teeheee/usring/README.md

# Us Sensor Ring (short usring) 

These are all files needed to manufacture, use, modify and programm the sensoring.
More information can be found in "doku/usring-doku.pdf".

# Credit

* twi library from Martin Junghans
* uart library from Peter Fleury
