teeheee/usring/layout/README

TODO:
	am multiplexer VEE->GND nicht VCC!!!
	sensor nummerierung überarbeiten
	10 poliger goldboard5 stecker
