teeheee/usring/doku/usring-doku.pdf

# Usring Dokumentation

Alexander Ulbrich

7. M¨arz 2018

1

## Inhaltsverzeichnis

1 Hardware | 2
2 Software | 3
3 Bestellliste | 7
4 Bestuckungsplan | 7 ¨

1

## 1 Hardware

### 1.1 Schaltplan


2

### 1.2 Bemaßung

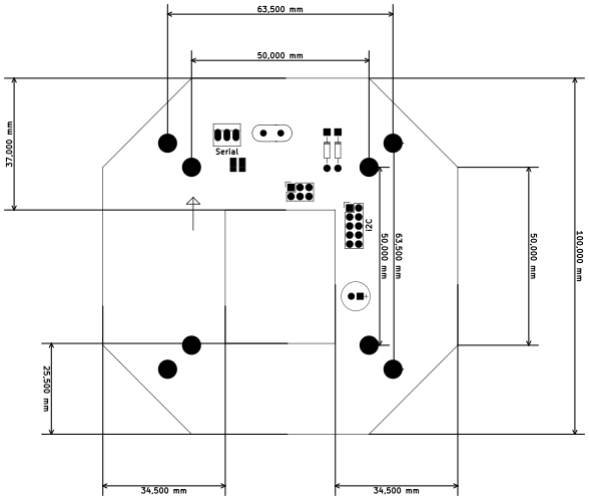
[picture p4: figure]

## 2 Software

### 2.1 usring Klasse

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

3

### 2.2 Verwendung der usring Klasse

### 2.2.1 Konstruktor

Initialisert die gesammte Hardware.

U s rin g ri n g ; // wie Goldboard gb;

### 2.2.2 Sensor getDifferenceValue

getDifferenceValue misst alle Sensoren einmal mit und einmal ohne LED Be-leuchtung. Die Differenz der Messung wird im int Array valueBuffer gespeichert. valueBuffer muss die Laenge 16 haben.

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

### 2.2.3 Sensor getAnalogValue

getAnalogValue gibt den Analogwert des Sensors mit der Nummer id zurueck. Achtung! Es wird keine Differenz gemessen.

ri n g . ge tAnalogValue ( u i n t 8 t i d ) ;

### 2.2.4 Sensor setLed

setLed schaltet die LED an, wenn state ¿ 0 und aus wenn state = 0 ist.

ri n g . se tLed ( u i n t 8 t s t a t e ) ;

### 2.2.5 I2C setI2C

setI2C setzt den Wert value in das register mit der Nummer id. Der Wert einer bestimmten id kann direkt ueber i2c vom Master ausgelesen werden.

ri n g . s e t I 2C ( u i n t 8 t id , u i n t 8 t v al u e ) ;

### 2.2.6 I2C setI2CData

setI2CData setzt den Wert der Register mit der Nummer id bis zur Nummer id+size auf Werte in dem Array data mit der l¨ange size.

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

Beispiel:

int x = 1 0;
ri n g . set I2CData ( 0 , 2 , ( u i n t 8 t ∗)&x ) ;

4

### 2.2.7 I2C getI2C

getI2C gibt den Wert des Eingangs Registers mit der Nummer id zurueck. der I2C Master hat die Moeglichkeit diese Register zu setzen.

ri n g . ge t I2C ( u i n t 8 t i d ) ;

### 2.2.8 UART print

gibt die Zeichenkette string ueber Uart aus.

ri n g . p r i n t ( const char∗ s t r i n g ) ;

gibt den Wert des Integeres value als ASCII ueber Uart aus.

ri n g . p r i n t ( int v al u e ) ;

### 2.3 Beispielcode

#i n cl u d e ” u s ri n g . h”

U s rin g ri n g ;

int mi t t el w e r t [ 1 6 ] ; int we r te [ 1 6 ] ;
u i n t 1 6 t ausgabe ;

void k a l i b r i e r e n ( )
{
// mittelwerte auf 0 setzen for ( int x = 0 ; x < 1 6; x++)
mi t t el w e r t [ x ] = 0 ;

//10 Messwerte Aufnehmen und den mittelwert Berechnen for ( int x = 0 ; x < 1 0; x++)
{
ri n g . g e t Di f f e r e n c e V al u e ( we r te ) ;
for ( int i = 0 ; i < 1 6; i++) mi t t el w e r t [ i ] += we r te [ i ] ; d el a y ( 1 0 ) ;
}
for ( int x = 0 ; x < 1 6; x++) mi t t el w e r t [ x ] /= 1 0;
}

void messen ( )
{
ri n g . g e t Di f f e r e n c e V al u e ( we r te ) ; }

5

void be rechnen ( )
{
// Schwellwerte auswerten und
// | Ergebnisse in 16 bit Typ Speichern
ausgabe = 0 ;
for ( int x = 0 ; x < 1 6; x++)
{
| // offset auf den mittelwert addieren if ( we r te [ x ] > mi t t el w e r t [ x ] + 1 0 )

{
| // setze das bit auf 1 wenn der sensor was sieht ausgabe |= (1<<x ) ;

}
}
}

// daten in i2c Puffer Schreiben void ausgeben ( )
{
//16 bit Variable schreiben
ri n g . set I2CData ( 0 , 2 , ( u i n t 8 t ∗)& ausgabe ) ; for ( int x = 0 ; x < 1 6; x++)
// analog werte schreiben
ri n g . s e t I 2C ( x+2, we r te [ x ] ) ;
}

int main ( void ) {
k a l i b r i e r e n ( ) ; while ( 1 ) {
messen ( ) ;
be rechnen ( ) ;
ausgeben ( ) ;
}
}

6

## 3 Bestellliste

Package | Anzahl | Wert
R 0805 | 16 | 470R
R 0805 | 3 | 1k
R 0805 | 17 | 10k
R 0805 | 2 | 4,7k
C 0805 | 4 | 100n
C 0805 | 2 | 22p
CP Radial D8.0mm P2.50mm | 1 | 100u
SFH3710 | 16 | SFH3710
1206 LED | 16 | LED
Diode throughole | 2 | D
SMD-shotkey | 1 | ZENER 5,1V
SOT23 | 1 | Q NMOS DGS
QUARZ-HC49 | 1 | QUARZ
Wannenstecker 2x05 | 1 | I2C
Shotkey-SOD-123 | 4 | D Schottky
atmega8-TQFP | 1 | ATMEGA88-A
74HC4051-SO16 | 2 | 74HC4051

## 4 Bestuckungsplan ¨

Bei der Bestuckung ist zu beachten, dass der Pin VEE mit GND verbunden ¨ werden muss (neben dran) die Verbindung mit VCC muss gekappt werden! Die Jumper 1 und 2 mussen wie folgt konfiguriert werden ¨


### 4.1 Oberseite

7

# 1x 10 - 100 uF, CP_Radial_Tantal_D8.0mm_P2.50mm

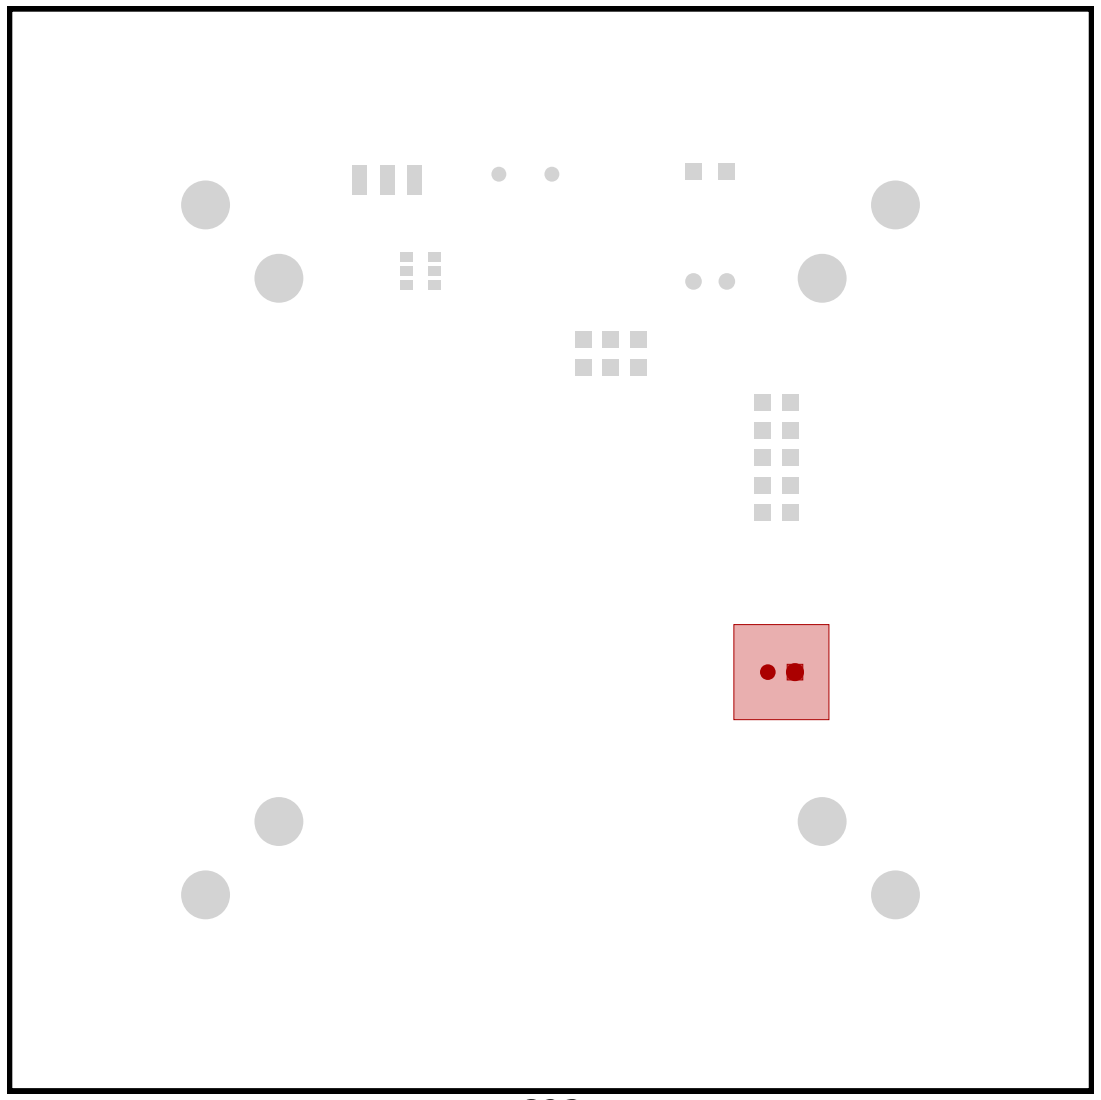
[picture p5: figure]

C23

# 2x D, Diode_throughole

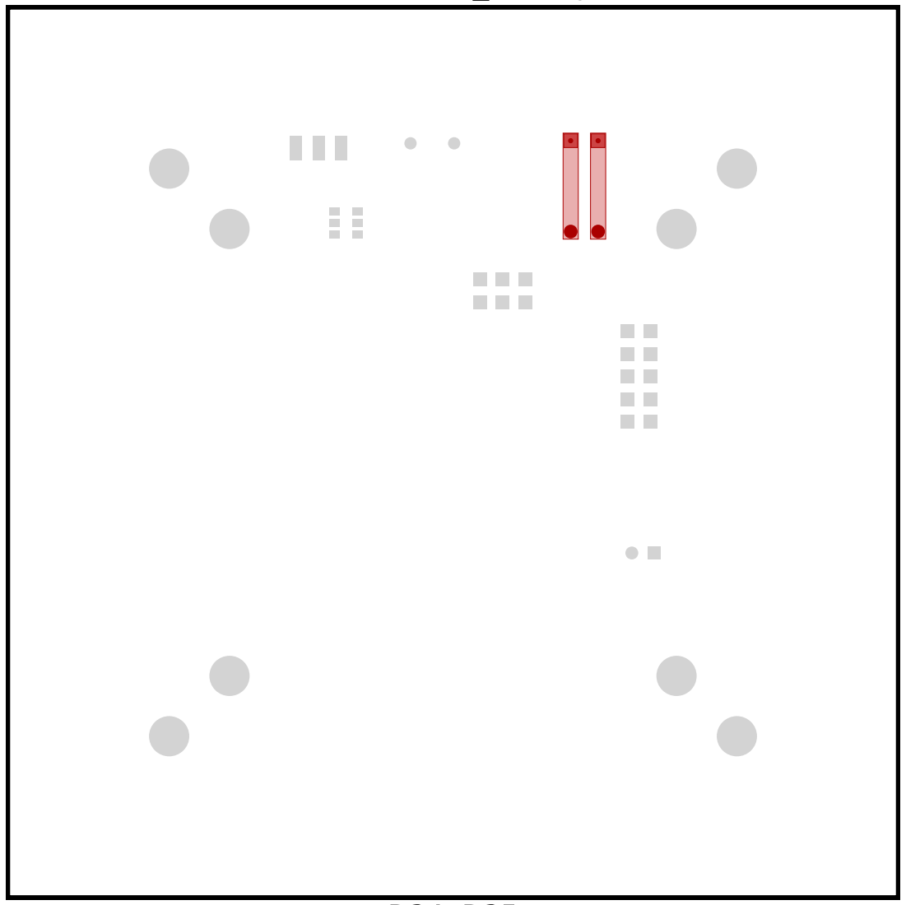
[picture p6: figure]

D34, D35

# 1x 16Mhz, QUARZ-HC49

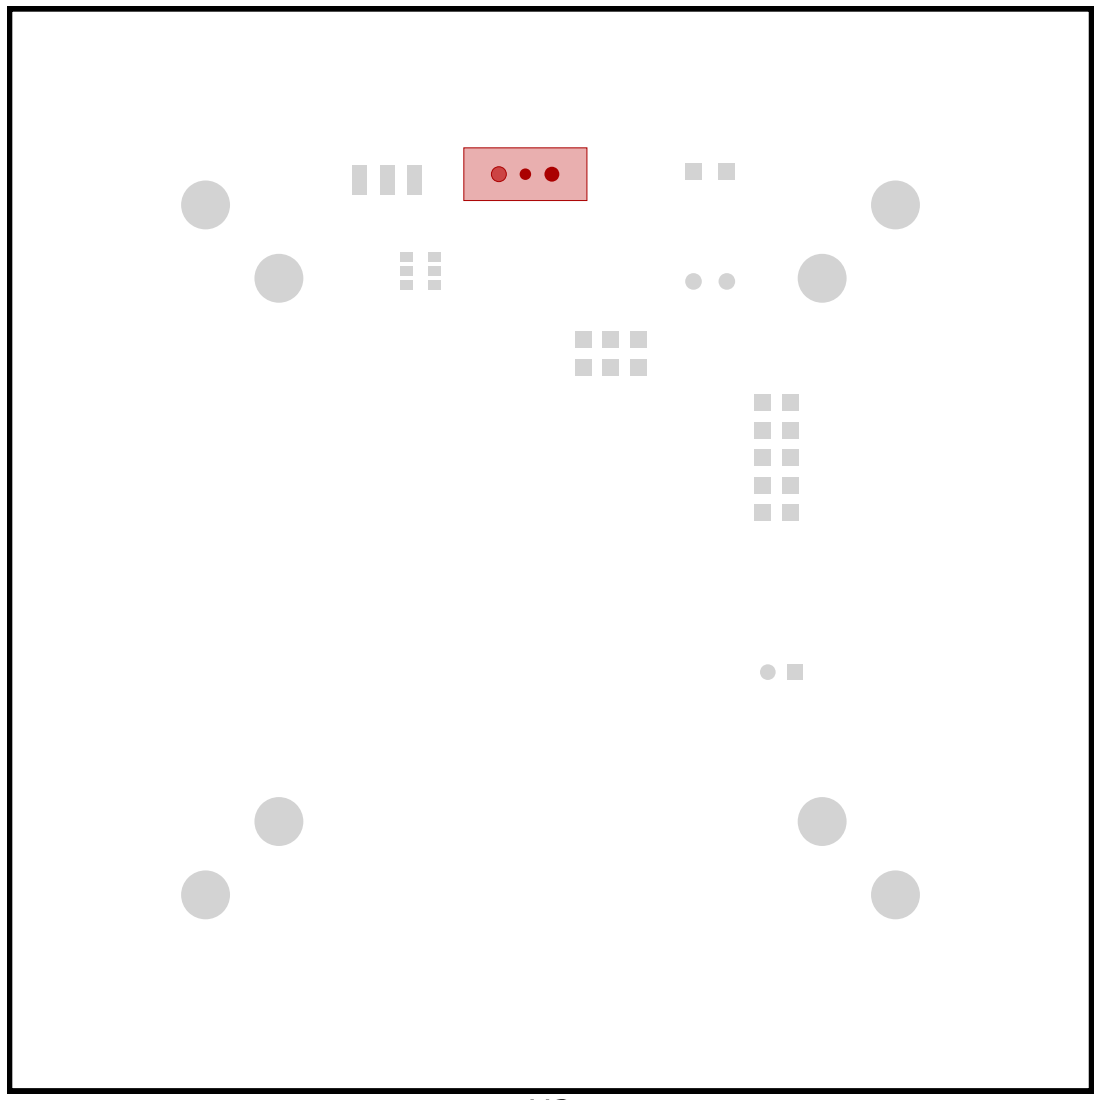
[picture p7: figure]

U3

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

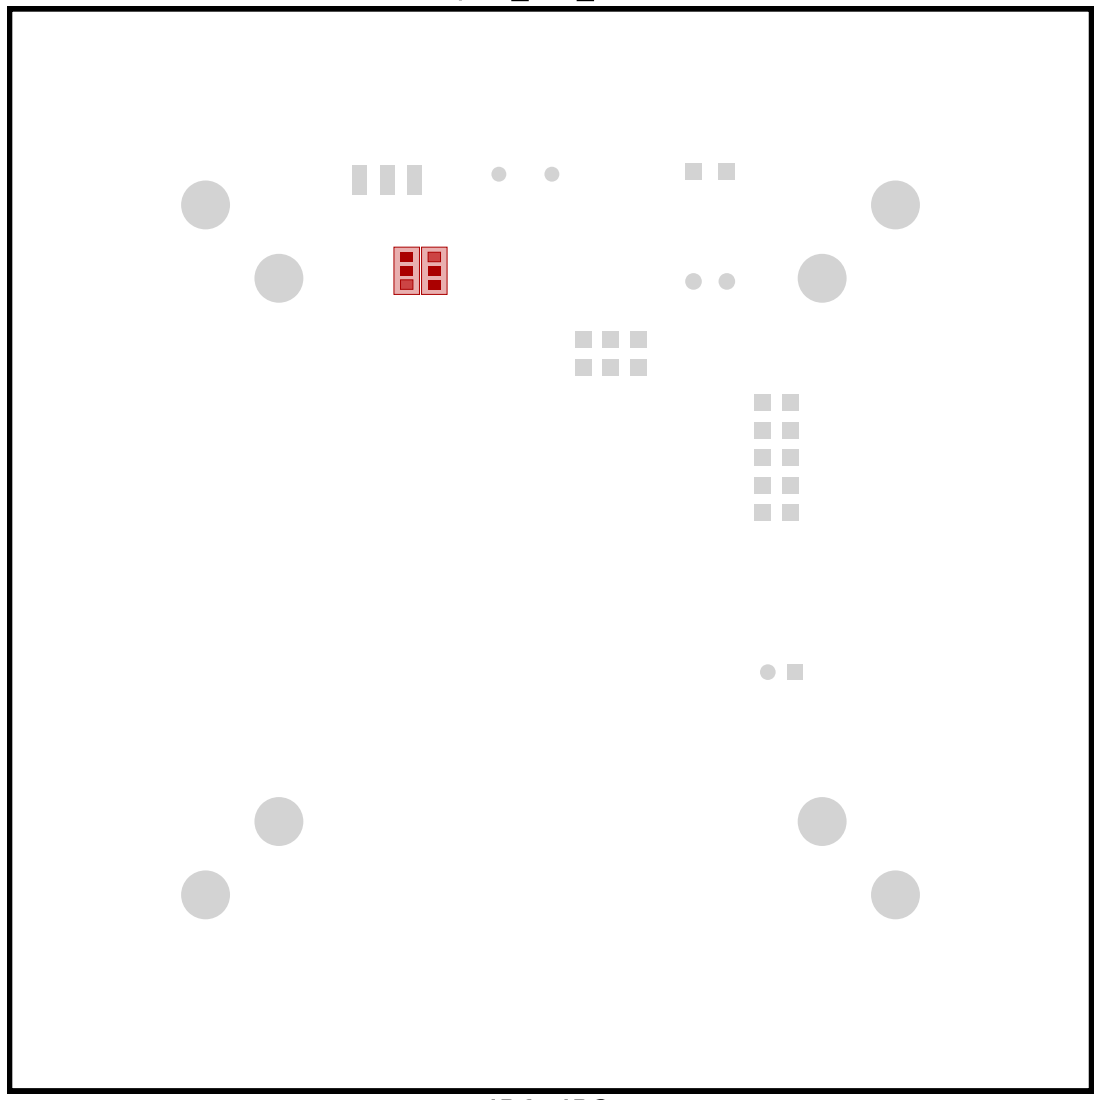
[picture p8: figure]

# 1x I2C, Wannenstecker_2x05

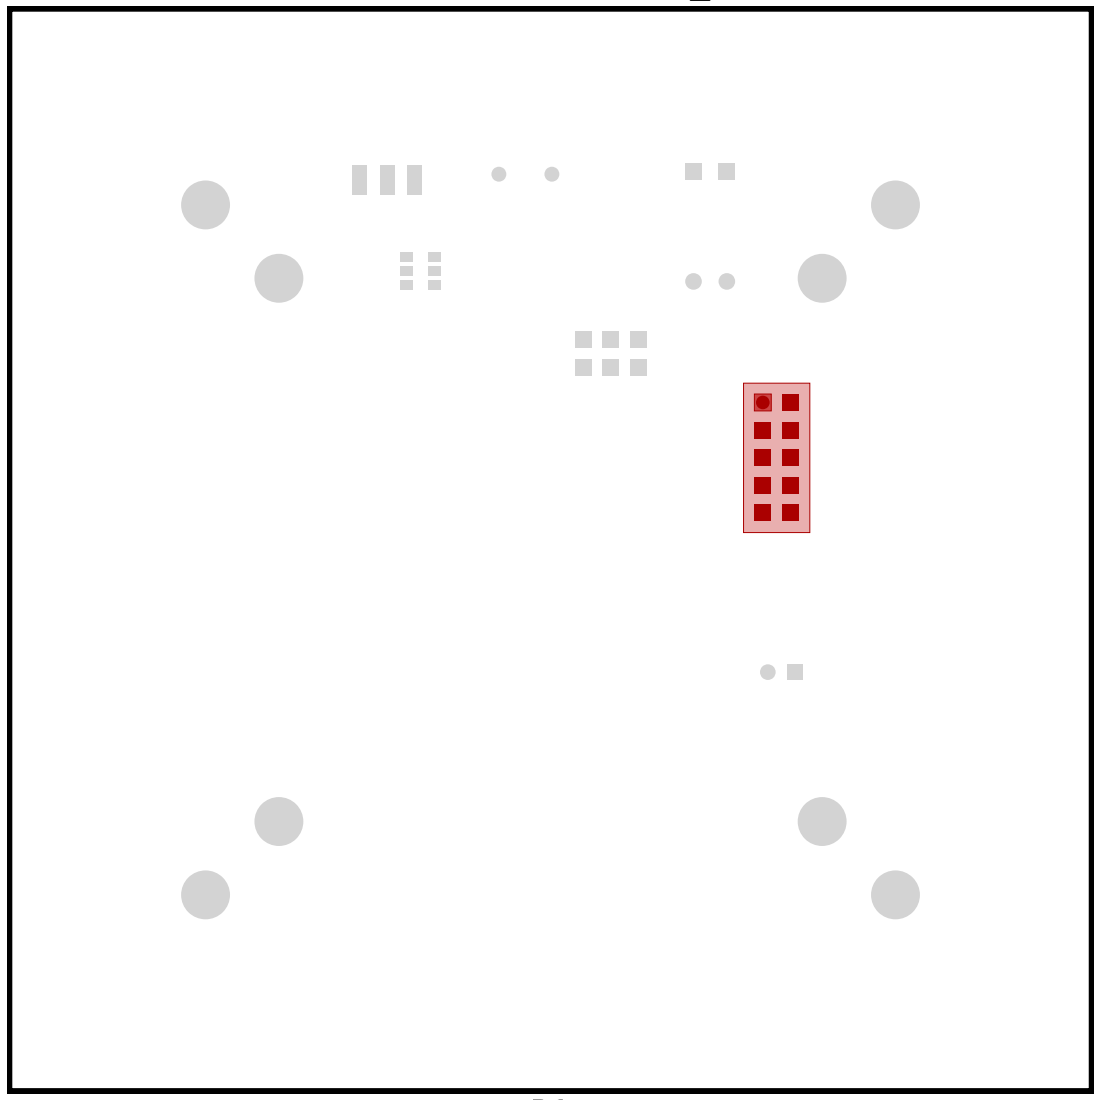
[picture p9: figure]

P1

### 4.2 Unterseite

13

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

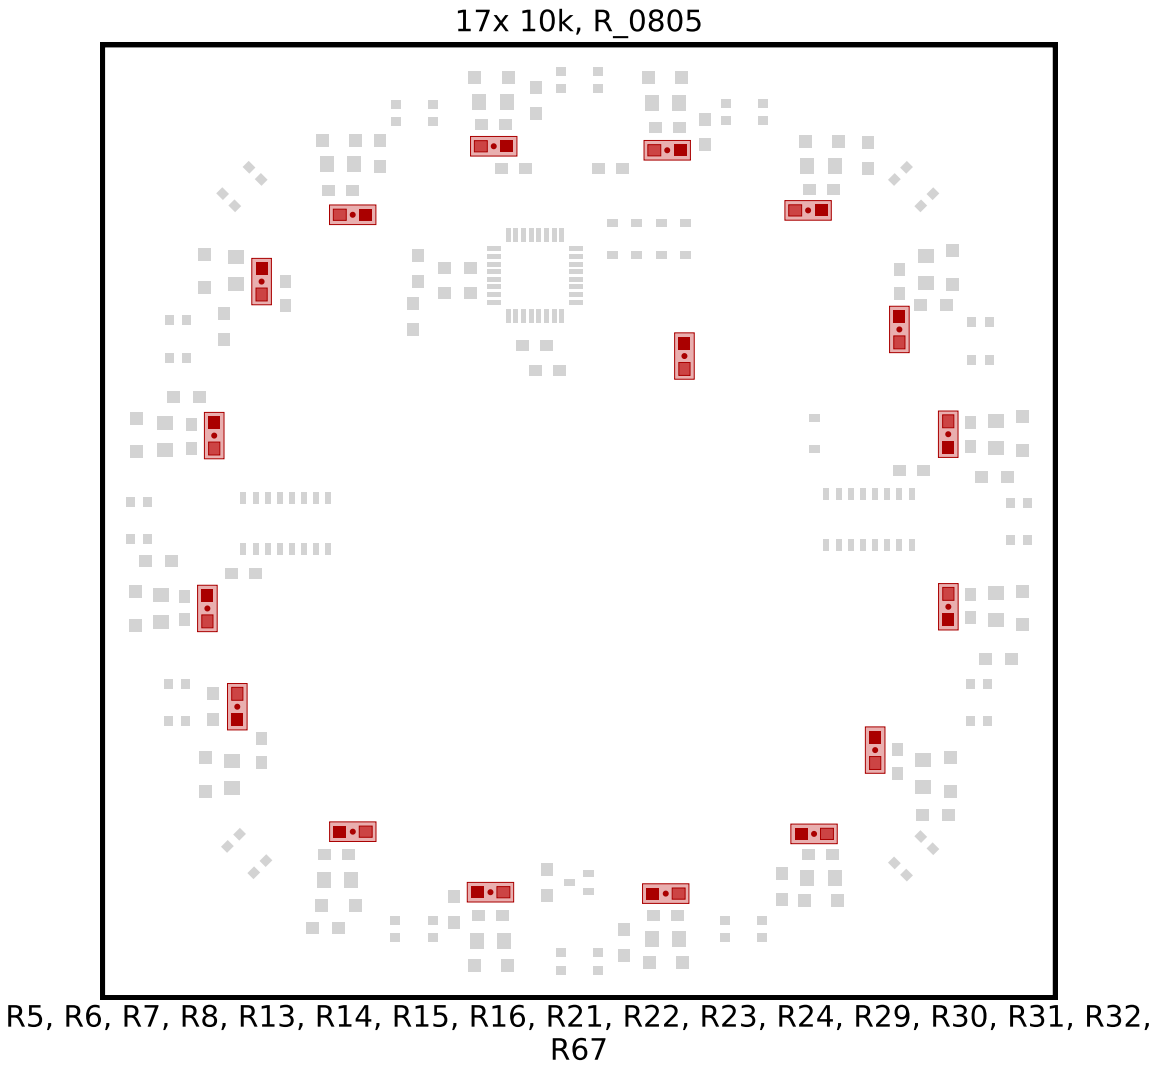
[picture p10: page 15]

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

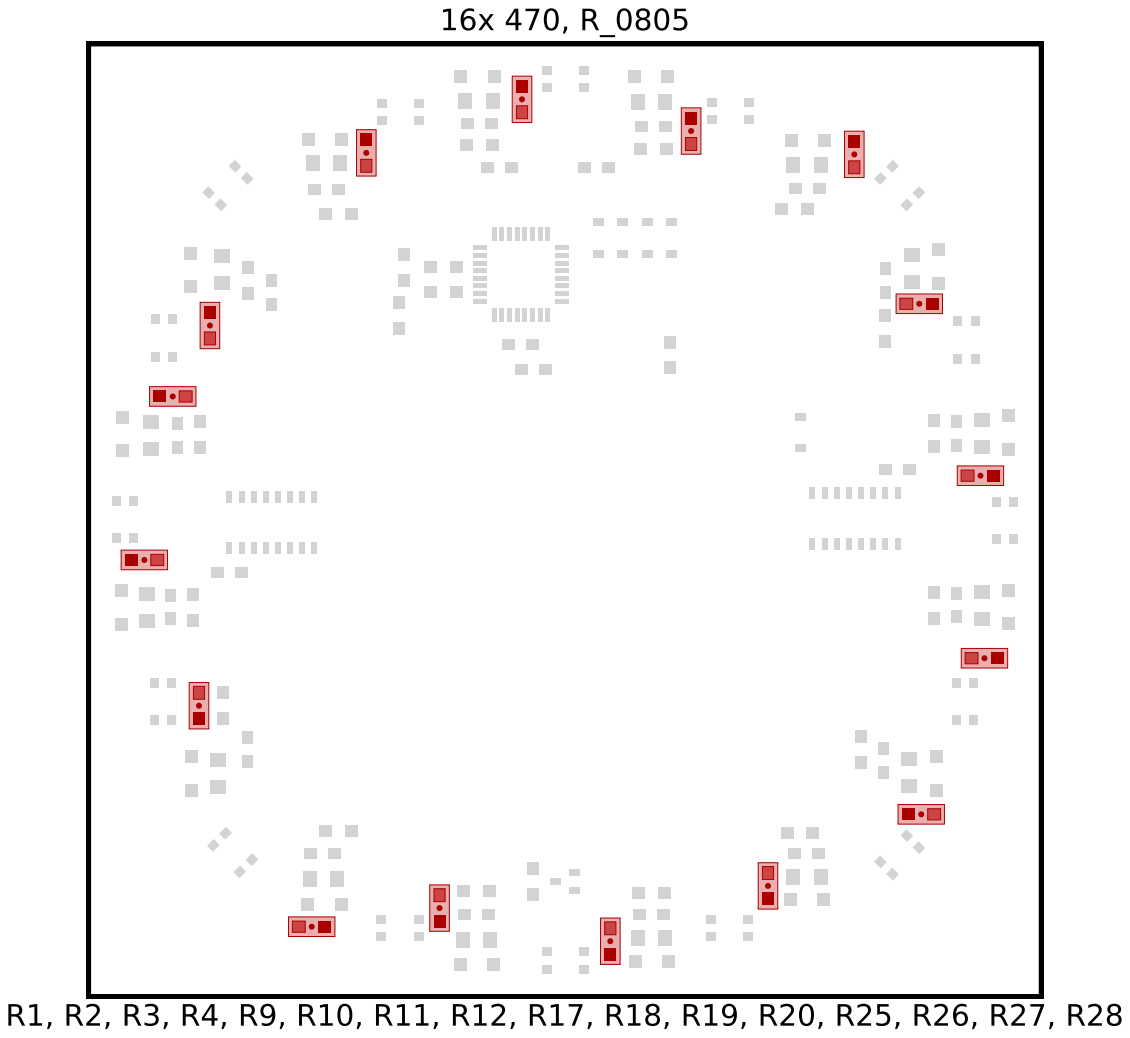
[picture p11: page 16]

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

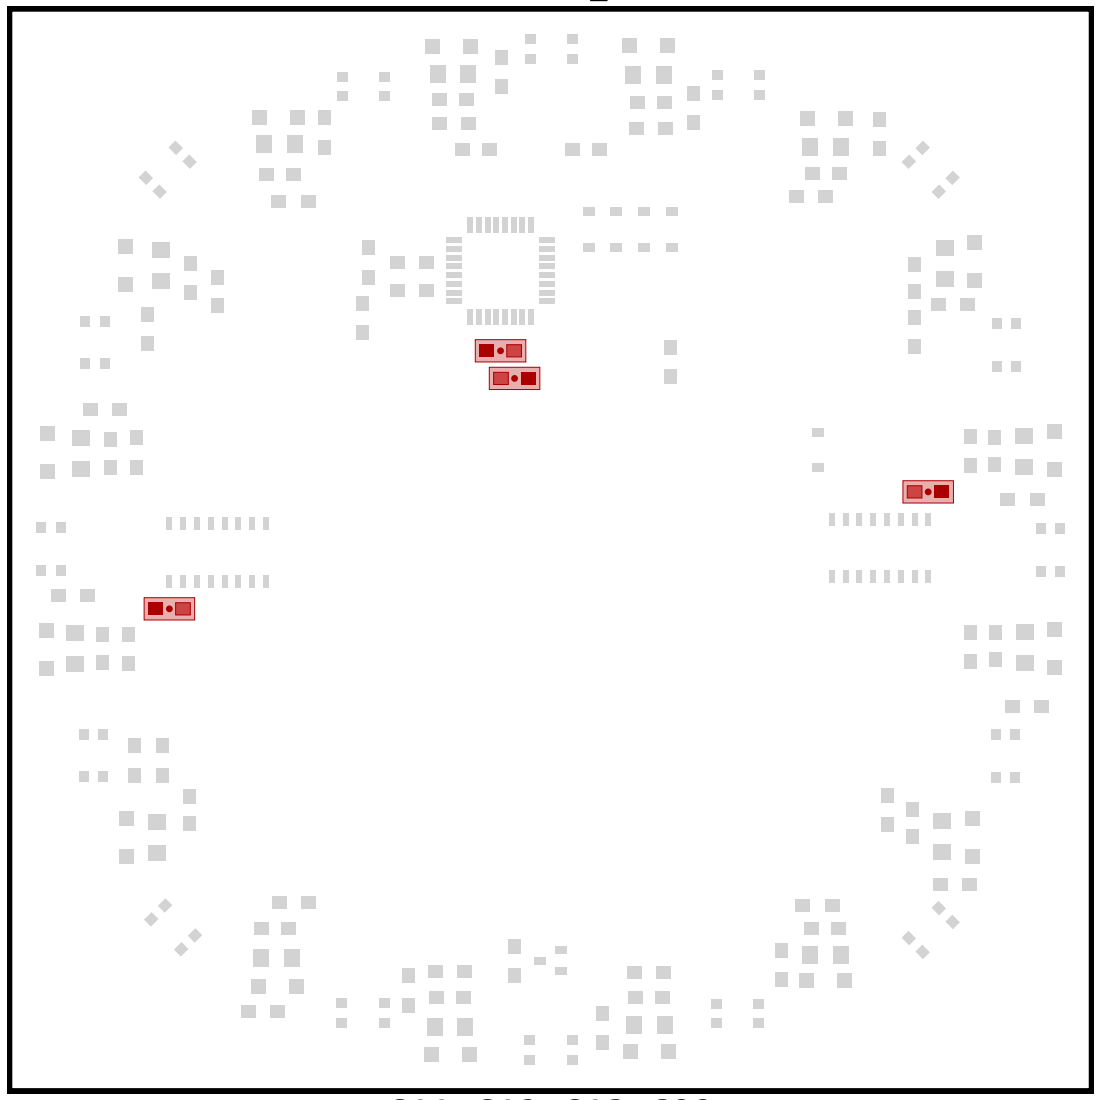
[picture p12: figure]

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

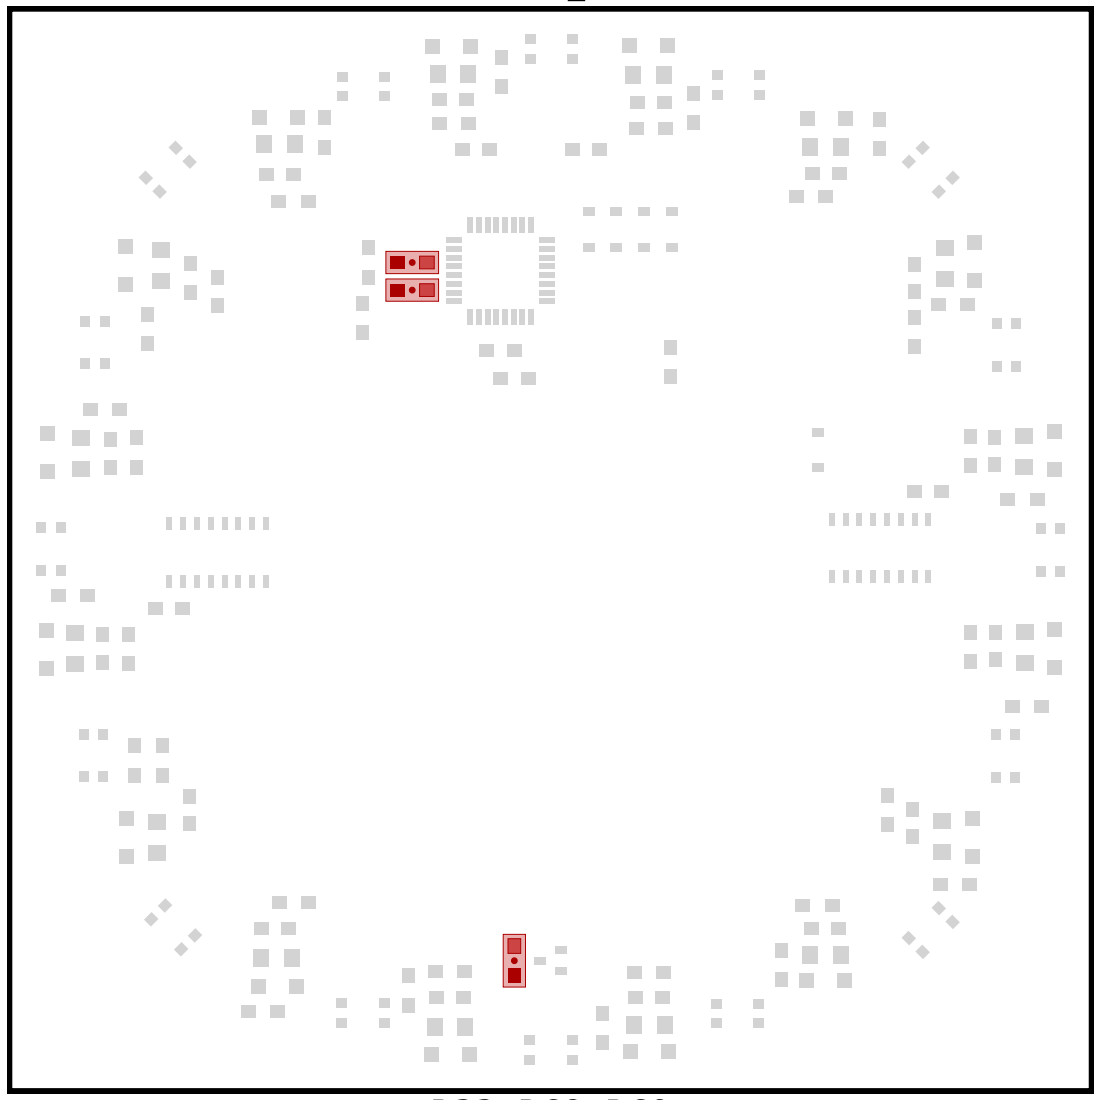
[picture p13: figure]

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

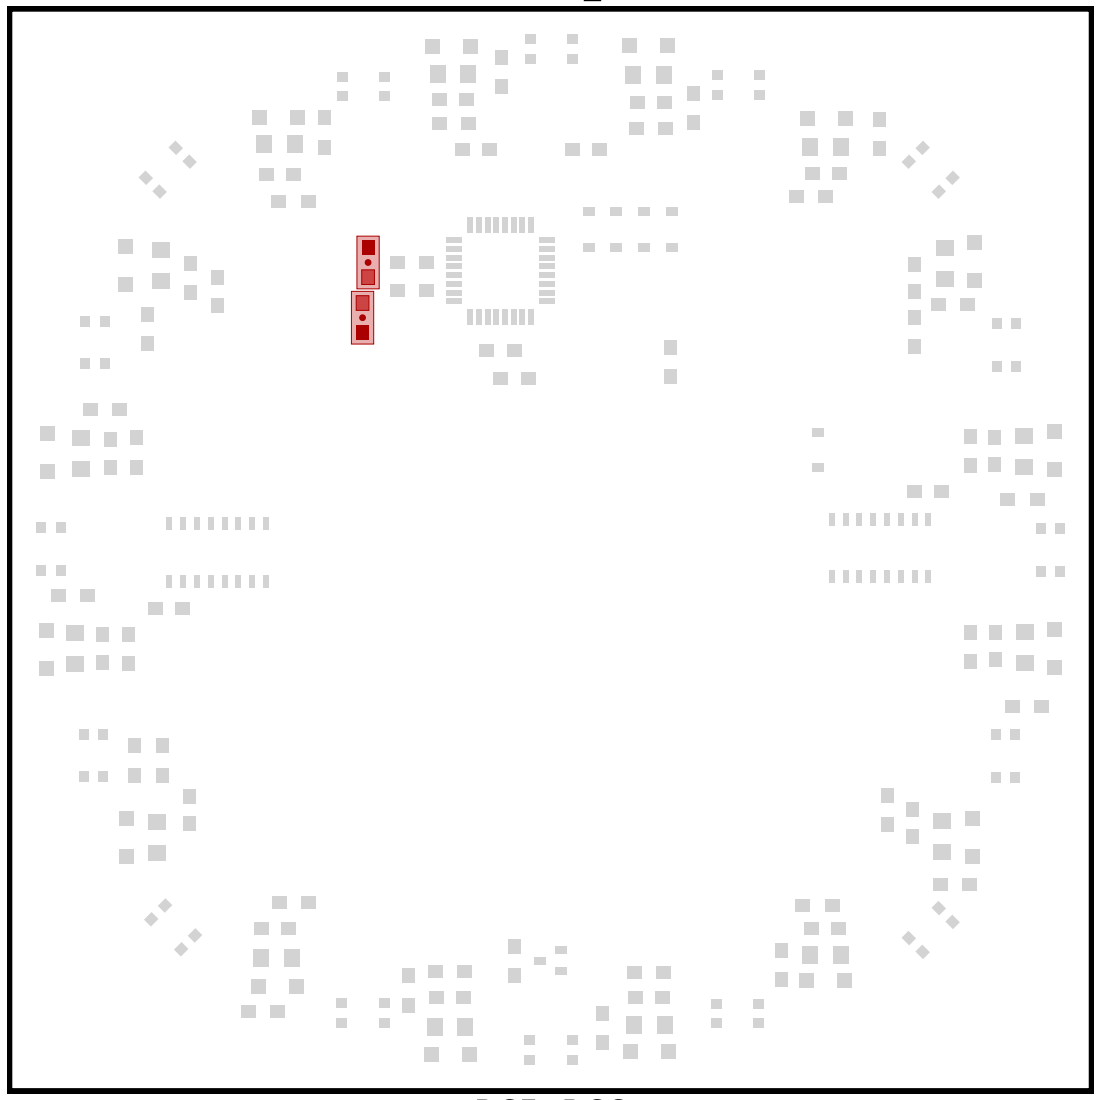
[picture p14: figure]

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

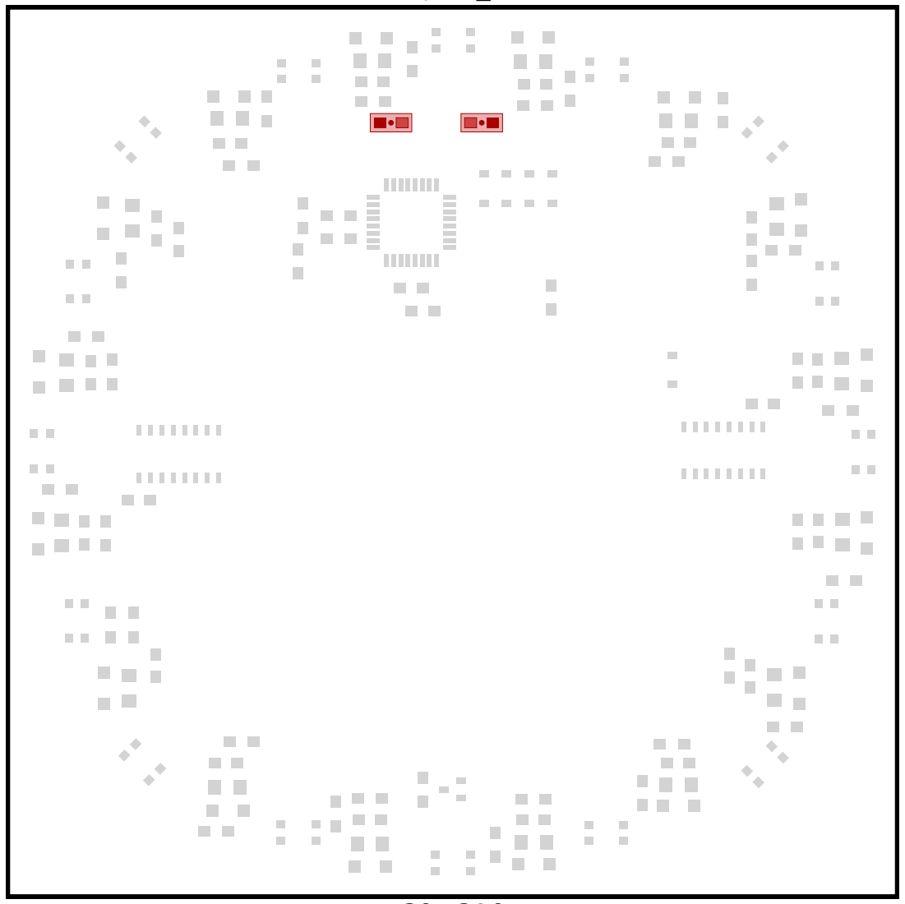
[picture p15: figure]

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

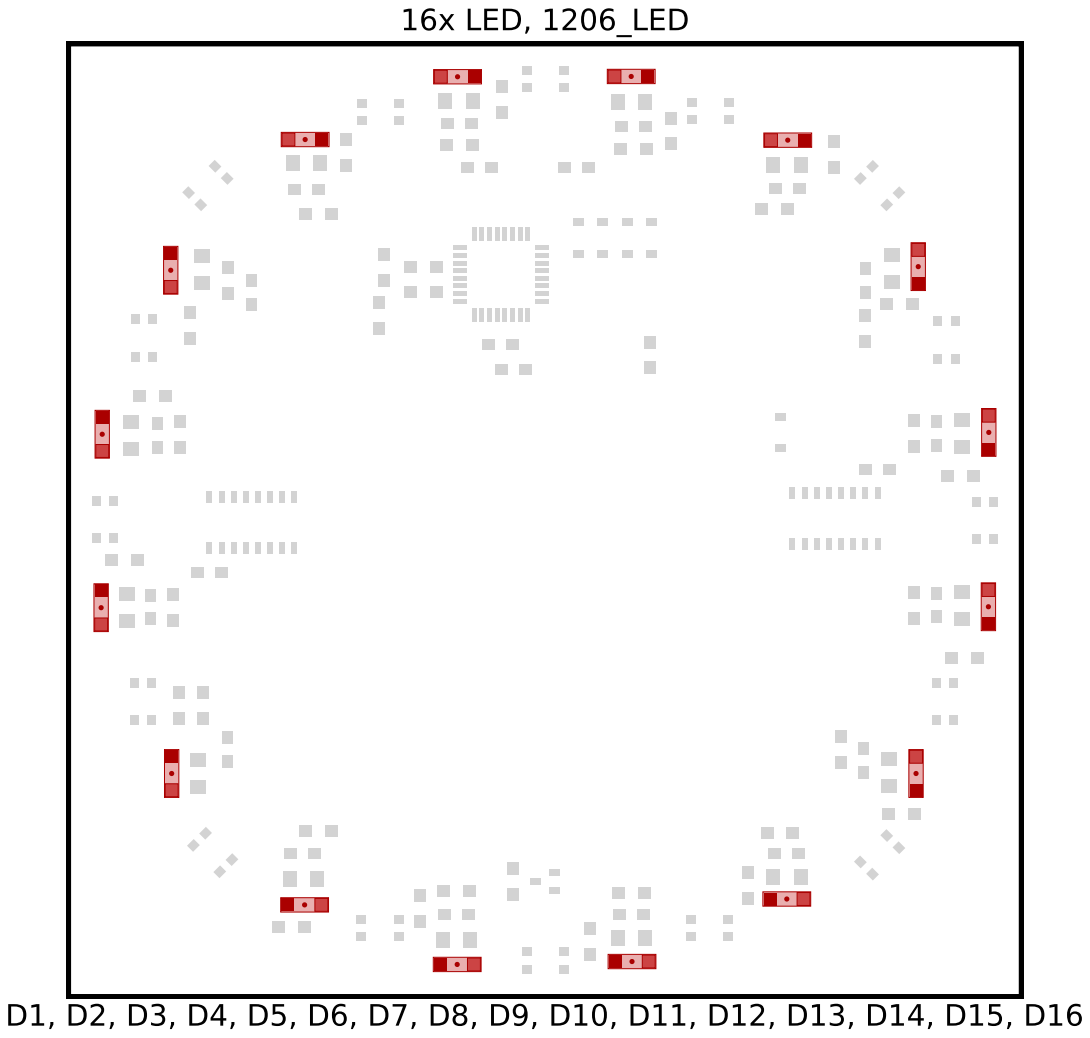
[picture p16: page 21]

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

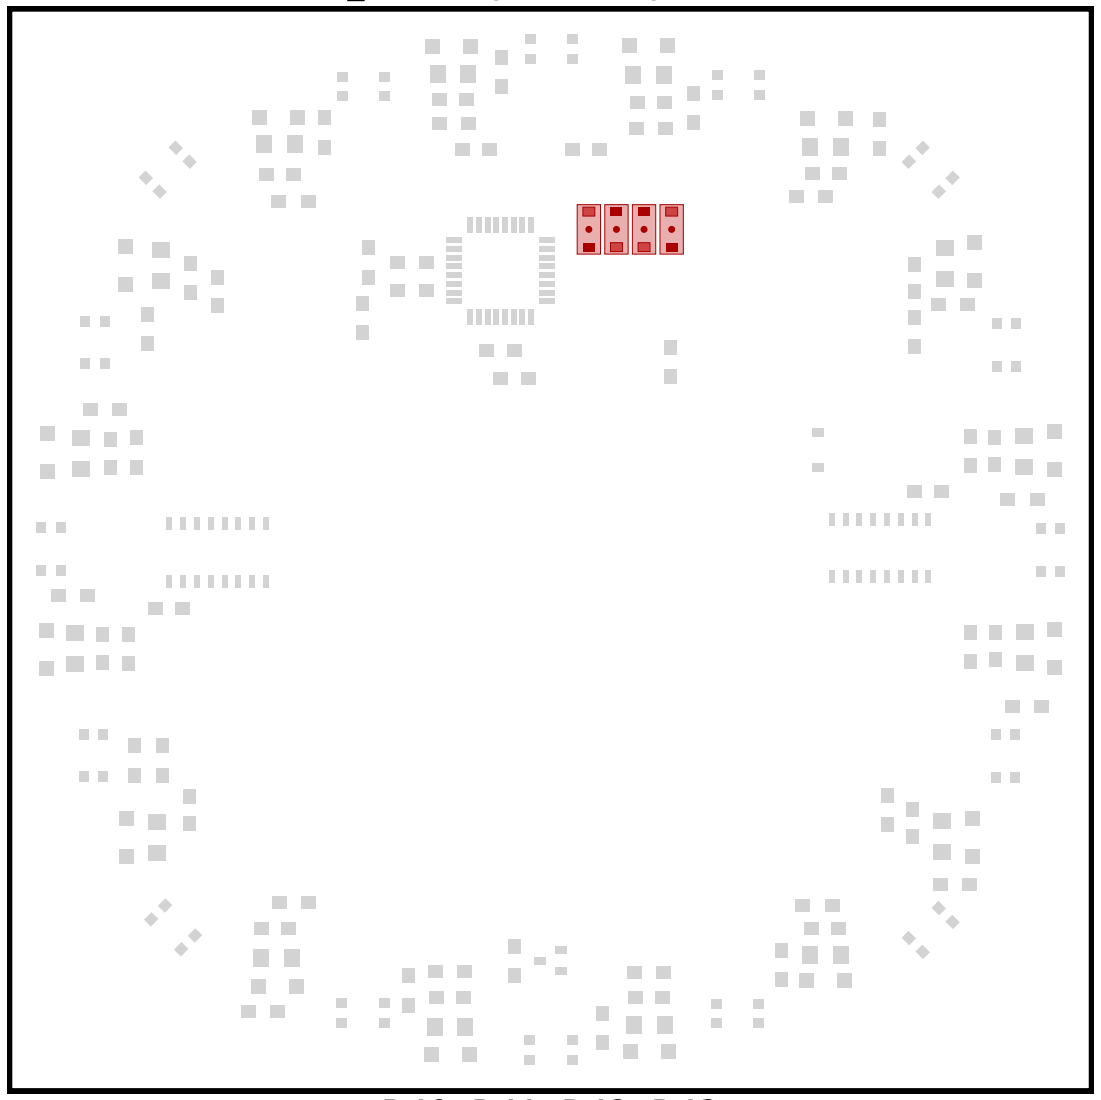
[picture p17: figure]

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

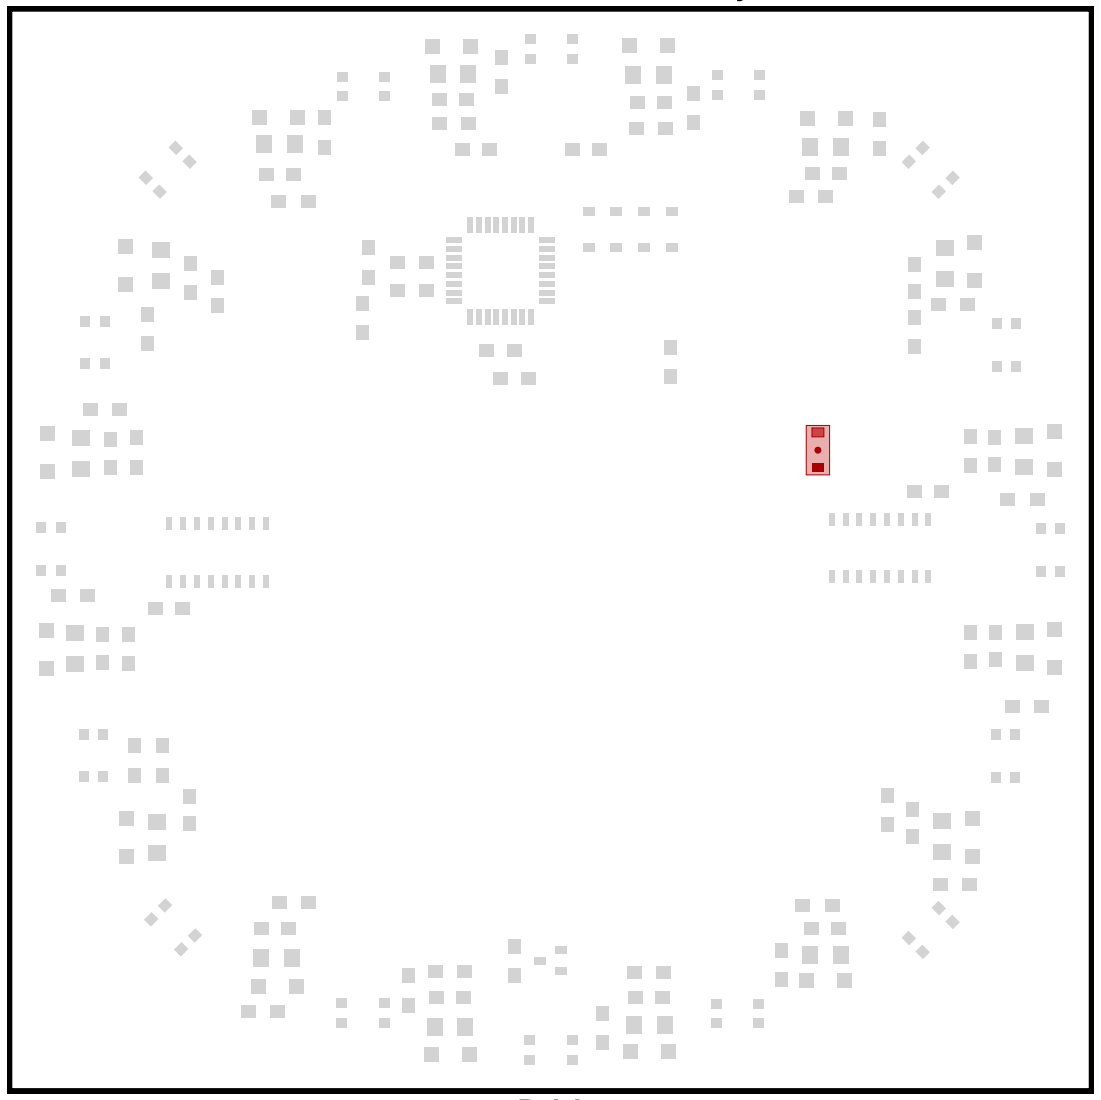
[picture p18: figure]

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

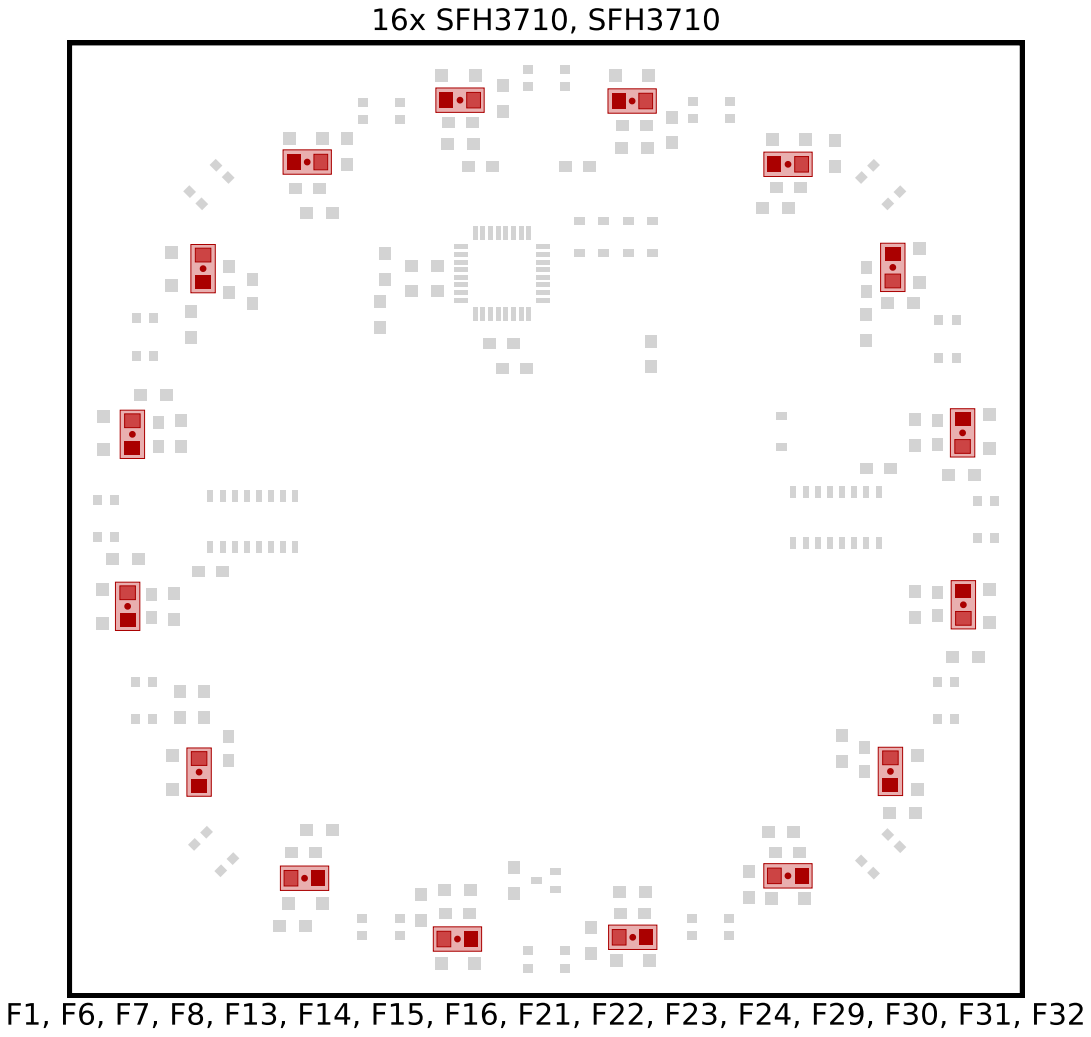
[picture p19: page 24]

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

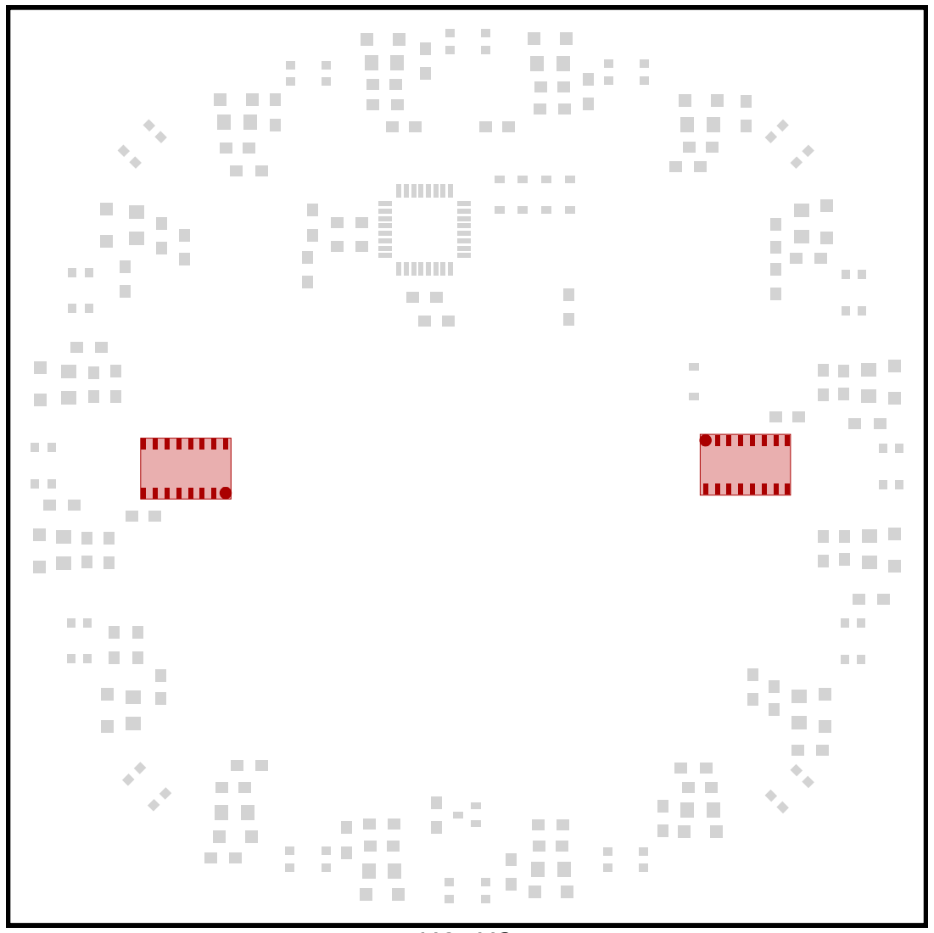
[picture p20: figure]

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

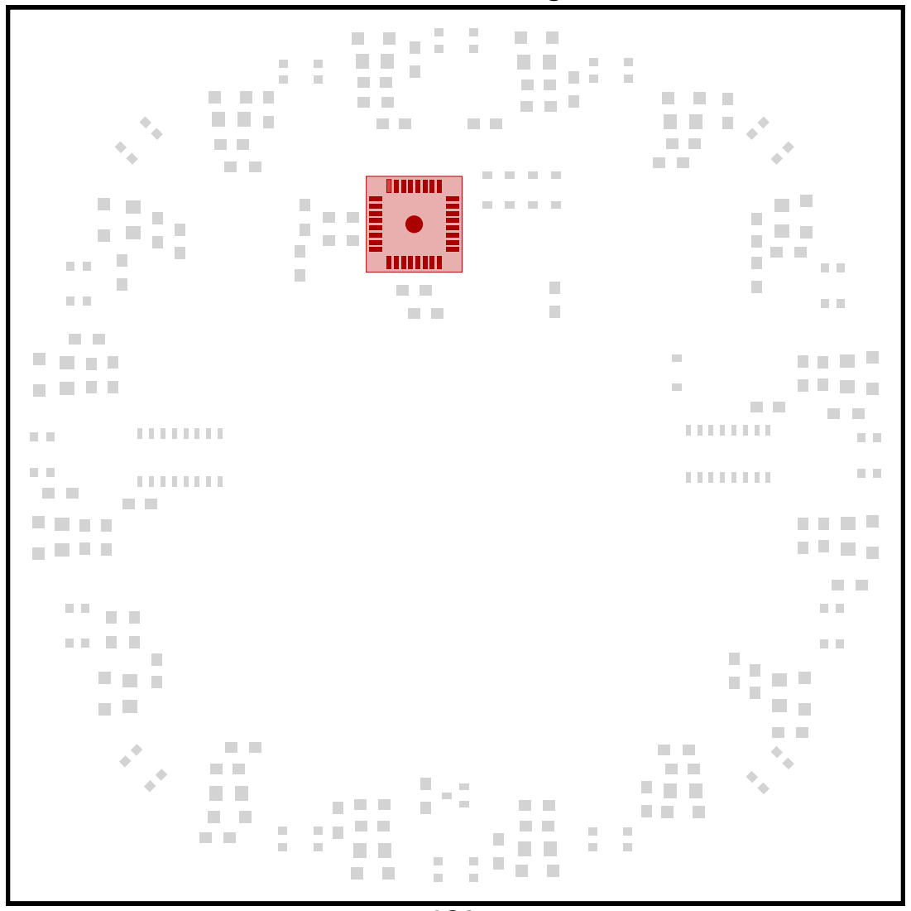
[picture p21: figure]

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

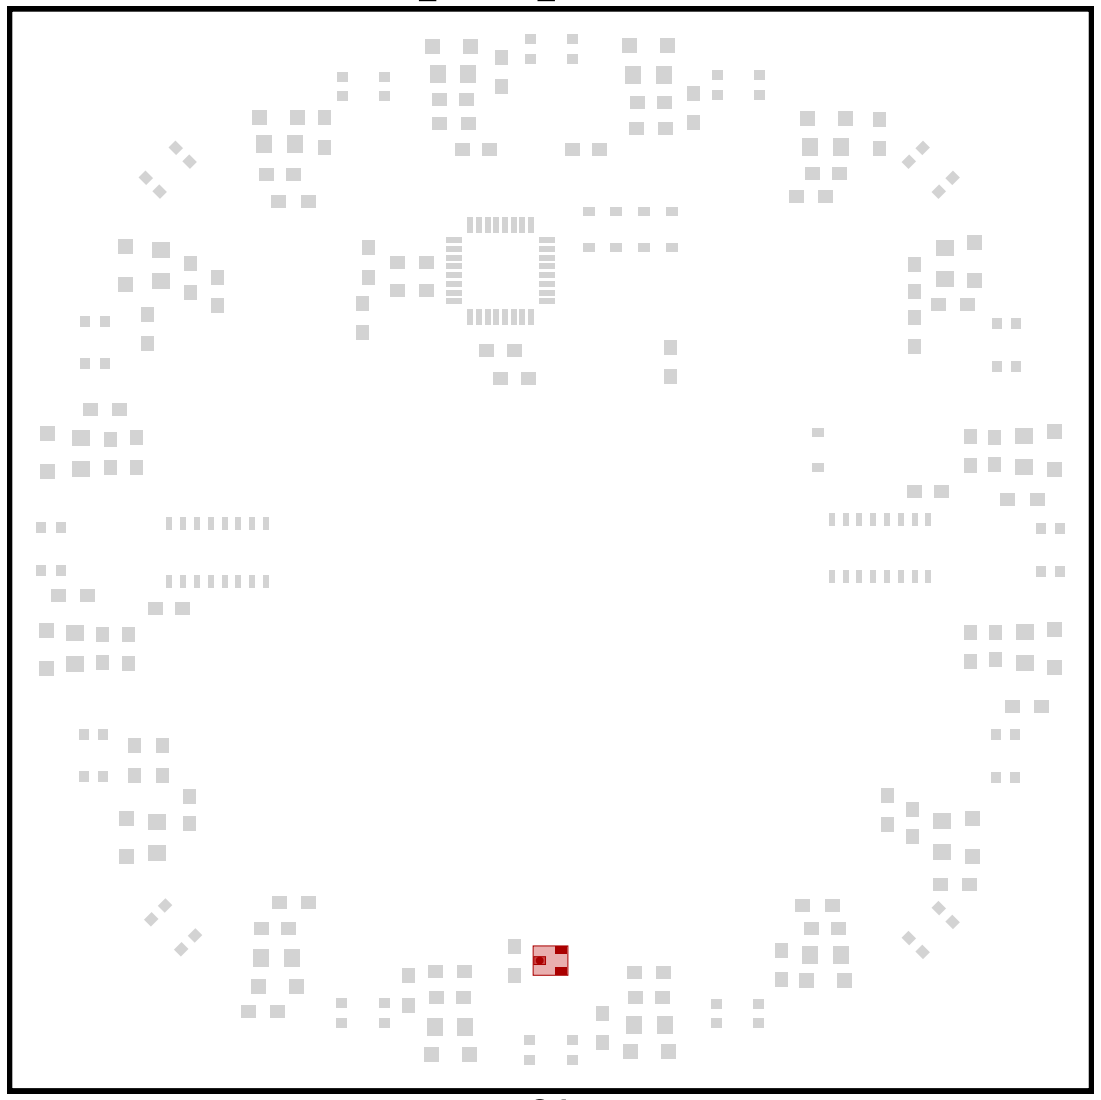
[picture p22: figure]
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
