teeheee/usring/doku/bom.ods

Package | Quantity | Designation | Supplier and ref
R_0805 | 16 | 470R | SMD-0805 470 (https://secure.reichelt.de/index.html?ARTICLE=32882)
R_0805 | 3 | 1k | SMD-0805 1,00K (https://www.reichelt.de/SMD-0805-von-1-bis-910-kOhm/SMD-0805-1-00K/3/index.html?ACTION=3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)
R_0805 | 17 | 10k | SMD-0805 10,0K (https://www.reichelt.de/SMD-0805-von-1-bis-910-kOhm/SMD-0805-10-0K/3/index.html?ACTION=3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)
R_0805 | 2 | 4,7k | SMD-0805 4,70K (https://www.reichelt.de/SMD-0805-von-1-bis-910-kOhm/SMD-0805-4-70K/3/index.html?ACTION=3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)
C_0805 | 4 | 100n | KEM X7R0805 100N (https://www.reichelt.de/Vielschicht-SMD-G0805/KEM-X7R0805-100N/3/index.html?ACTION=3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)
C_0805 | 2 | 22p | KEM C0G0805 22P (https://www.reichelt.de/Vielschicht-SMD-G0805/KEM-C0G0805-22P/3/index.html?ACTION=3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)
CP_Radial_Tantal_D8.0mm_P2.50mm | 1 | 100u | SM 100/16RAD (https://www.reichelt.de/Elkos-radial-subminiatur/SM-100-16RAD/3/index.html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)
SFH3710 | 16 | SFH3710 | SFH 320 (https://secure.reichelt.de/index.html?ARTICLE=65220)
1206_LED | 16 | LED | LED LL 1206 WW (https://www.reichelt.de/SMD-LEDs-Standard/LED-LL-1206-WW/3/index.html?ACTION=3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)
Diode_throughole | 2 | D | 1N 4006 (https://www.reichelt.de/1N-UF-AA-Dioden/1N-4006/3/index.html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)
SMD-shotkey | 1 | ZENER | SMD ZF 5,1 (https://www.reichelt.de/SMD-Z-Dioden-Mini-Melf/SMD-ZF-5-1/3/index.html?ACTION=3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)
SOT23 | 1 | Q_NMOS_DGS | BSS 138-7-F DII (https://www.reichelt.de/BS-Transistoren/BSS-138-7-F-DII/3/index.html?ACTION=3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)
QUARZ-HC49 | 1 | QUARZ | 16,0000-HC49U-S (https://www.reichelt.de/Quarze/16-0000-HC49U-S/3/index.html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)
Wannenstecker_2x05 | 1 | I2C | WSL 10G (https://www.reichelt.de/Pfosten-Wannenstecker/WSL-10G/3/index.html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)
Shotkey-SOD-123 | 4 | D_Schottky | SD 103BW (https://www.reichelt.de/SB-SKE-4F-Dioden/SD-103BW/3/index.html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)
atmega8-TQFP | 1 | ATMEGA88-A | ATMEGA 8-16 TQ (https://www.reichelt.de/Atmel-ATMega-AVRs/ATMEGA-8-16-TQ/3/index.html?ACTION=3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)
74HC4051-SO16 | 2 | 74HC4051 | SMD HC 4051 (https://secure.reichelt.de/index.html?ARTICLE=18687)
