teeheee/usring/layout/lptfinal/stencil/stencil.stl

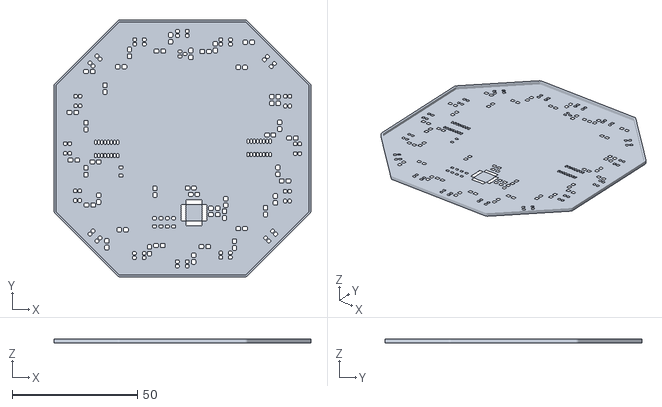
[picture p23: CAD file, 2018-12-21]
layout/lptfinal/stencil/stencil.stl
102.8 x 102.8 x 1.50
