teeheee/usring/layout/lptfinal/stencil/usring_infrared-Edge.Cuts.dxf

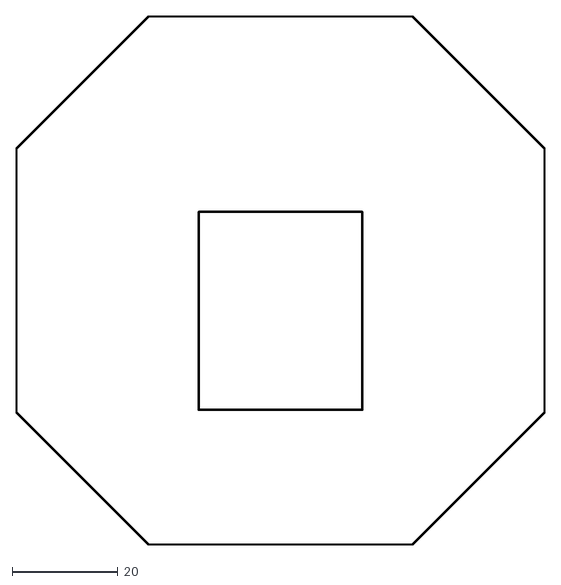
[picture p24: CAD file, 2018-12-21]
layout/lptfinal/stencil/usring_infrared-Edge.Cuts.dxf
100.2 x 100.2
