teeheee/usring/(list of files, cad)

Other CAD files:
layout/lptfinal/stencil/usring_infrared-B.Paste.dxf
layout/lptfinal/stencil/usring_infrared-F.Paste.dxf
layout/lptfinal/stencil/usring_noInfrared-B.Paste.dxf
layout/lptfinal/stencil/usring_noInfrared-F.Paste.dxf
