teeheee/usring/layout/usring.kicad_pcb

## KiCad design layout/usring.kicad_pcb (2018-03-07)

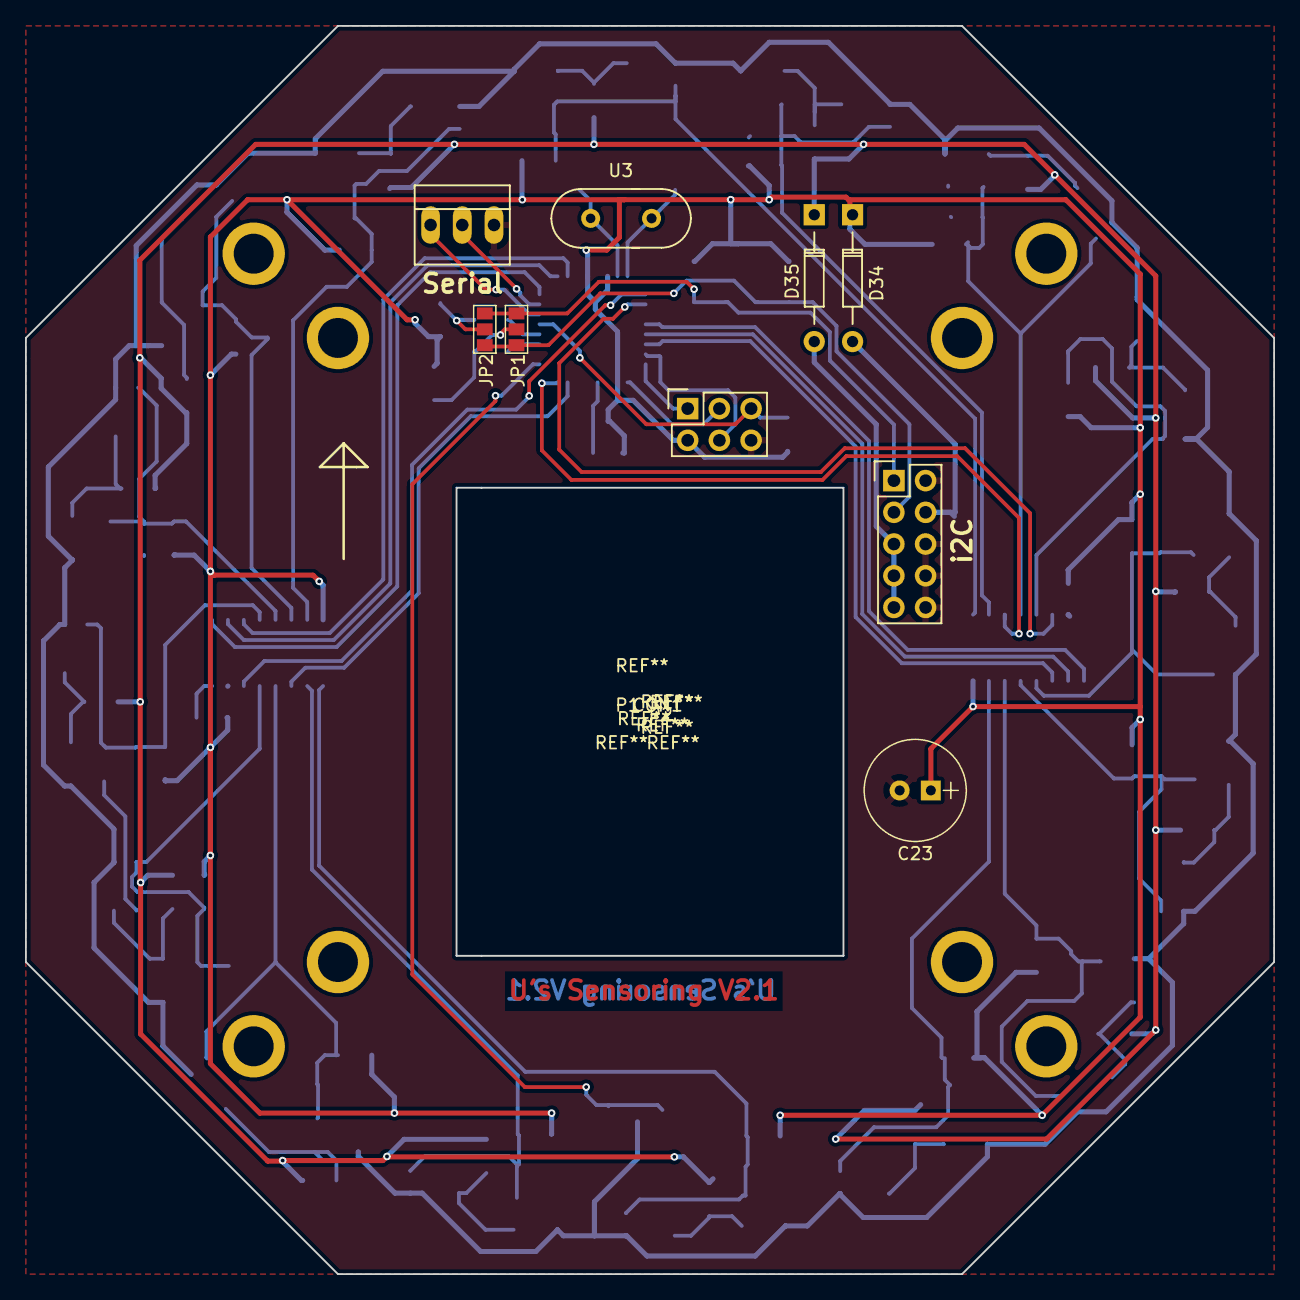
[picture p25: board usring.kicad_pcb from above]

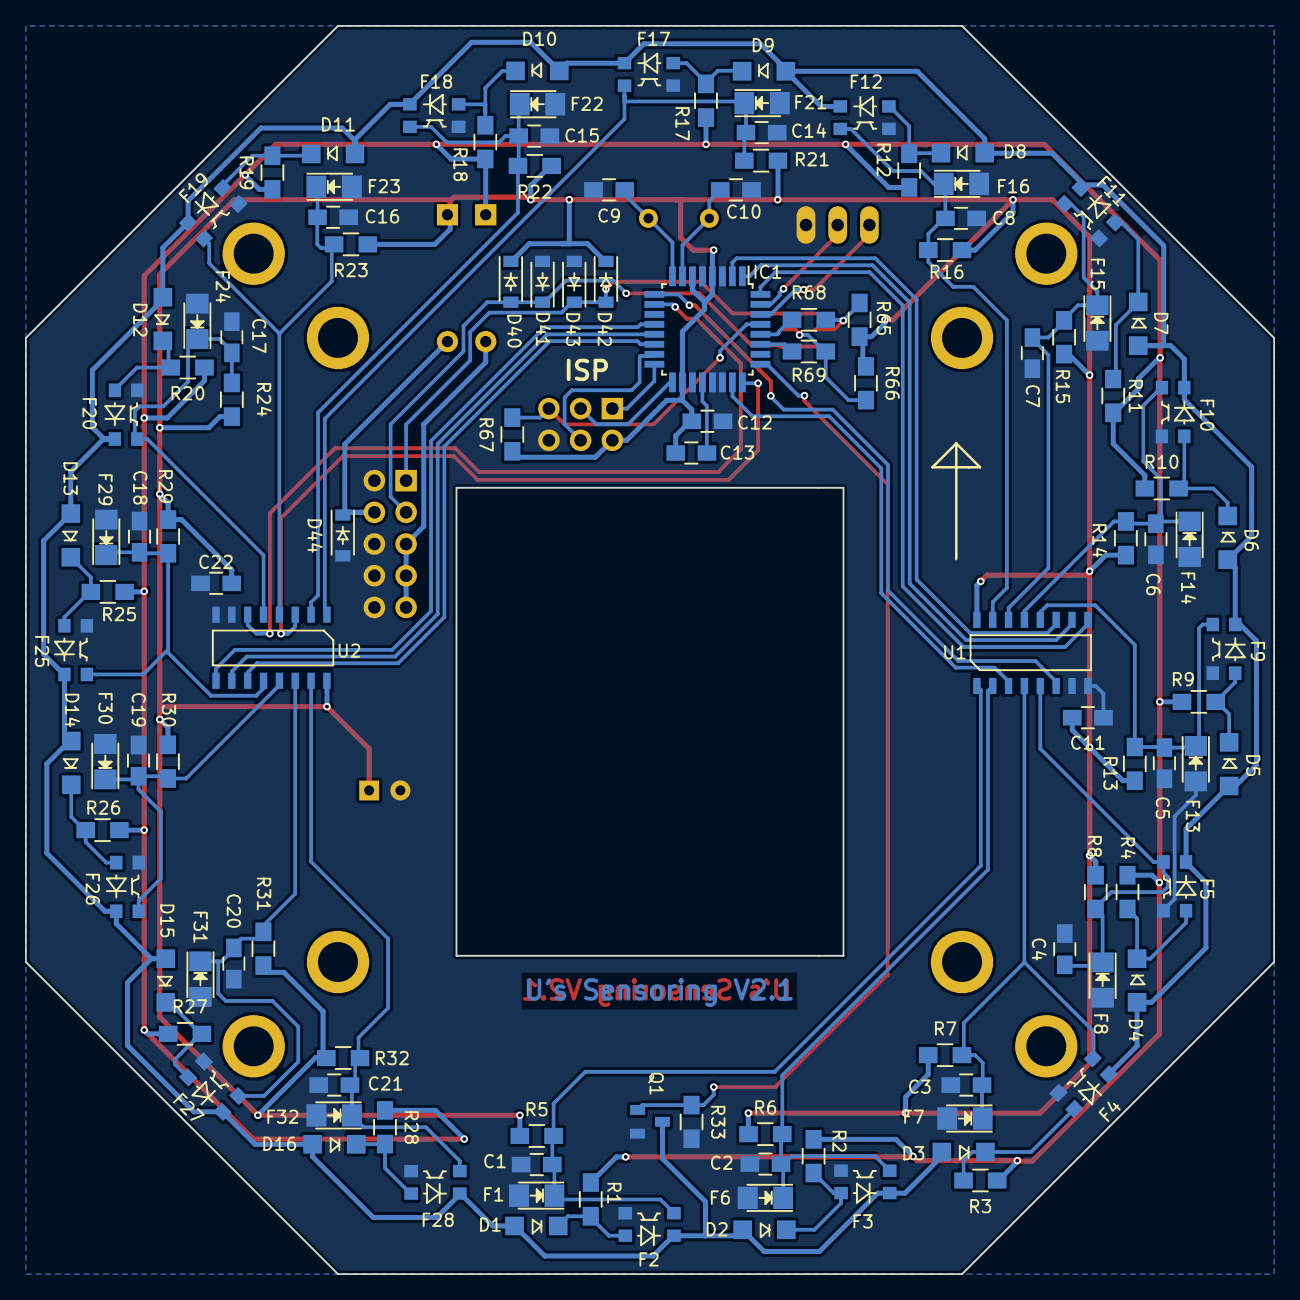
[picture p26: board usring.kicad_pcb from below]

Board: 2 copper layers, 100.0 x 100.0 mm, 126 parts (117 on the bottom side), 64 nets.

Parts:
C1, C2, C3, C4, C5, C6, C7, C8, C14, C15, C16, C17, C18, C19, C20, C21: 1n; C_0805
C9, C10: 22p; C_0805
C11, C12, C13, C22: 100n; C_0805
C23: CP; CP_Radial_Tantal_D8.0mm_P2.50mm
CON1: AVR-ISP-6; AVR-ISP
D1, D2, D3, D4, D5, D6, D7, D8, D9, D10, D11, D12, D13, D14, D15, D16: LED; 1206_LED
D34, D35: D; Diode_throughole
D40, D41, D42, D43: D_Schottky; Shotkey-SOD-123
D44: ZENER; SMD-shotkey
F1, F6, F7, F8, F13, F14, F15, F16, F21, F22, F23, F24, F29, F30, F31, F32: SFH3710
F2, F3, F4, F5, F9, F10, F11, F12, F17, F18, F19, F20, F25, F26, F27, F28: QRE1113
IC1: ATMEGA88-A; atmega8-TQFP
JP1, JP2: Jumper_NC_Dual; GS3
P1: I2C; Pin_Header_Straight_2x05
P2: serial; PINHEAD1-3
Q1: Q_NMOS_DGS; SOT23
R1, R2, R3, R4, R9, R10, R11, R12, R17, R18, R19, R20, R25, R26, R27, R28: 470; R_0805
R5, R6, R7, R8, R13, R14, R15, R16, R21, R22, R23, R24, R29, R30, R31, R32, R67: 10k; R_0805
R33, R68, R69: 1k; R_0805
R65, R66: 4,7k; R_0805
U1, U2: 74HC4051; 74HC4051-SO16
U3: QUARZ; QUARZ-HC49

Connections:
5V_IN: D34.2, D44.1, P1.4
12V_IN: D35.2, P1.5, P1.7, P1.9
A0: IC1.2, U1.11
A1: IC1.14, U2.11
ADC0: IC1.23, U1.3
ADC1: IC1.24, U2.3
B0: IC1.1, U1.10
B1: IC1.13, U2.10
C0: IC1.32, U1.9
C1: IC1.12, U2.9
GND: C1.2, C2.2, C3.2, C4.2, C5.2, C6.2, C7.2, C8.2, C9.2, C10.2, C11.2, C12.2, C14.2, C15.2, C16.2, C17.2, C18.2, C19.2, C20.2, C21.2, C22.2, C23.2, CON1.6, D41.2, D43.2, D44.2, F1.2, F2.4, F3.4, F4.4, F5.4, F6.2, F7.2, F8.2, F9.4, F10.4, F11.4, F12.4, F13.2, F14.2, F15.2, F16.2, F17.4, F18.4, F19.4, F20.4, F21.2, F22.2, F23.2, F24.2, F25.4, F26.4, F27.4, F28.4, F29.2, F30.2, F31.2, F32.2, IC1.3, IC1.5, IC1.19, IC1.21, IC1.22, P1.2, P1.6, P1.8, P1.10, P2.3, Q1.3, R33.2, U1.7, U1.8, U2.7, U2.8
INH0: IC1.9, U1.6
INH1: IC1.10, U2.6
LED: IC1.25, Q1.2, R33.1
LEDGND: D1.1, D2.1, D3.1, D4.1, D5.1, D6.1, D7.1, D8.1, D9.1, D10.1, D11.1, D12.1, D13.1, D14.1, D15.1, D16.1, F2.2, F3.2, F4.2, F5.2, F9.2, F10.2, F11.2, F12.2, F17.2, F18.2, F19.2, F20.2, F25.2, F26.2, F27.2, F28.2, Q1.1
LEDPOWER: D35.1, R1.1, R2.1, R3.1, R4.1, R9.1, R10.1, R11.1, R12.1, R17.1, R18.1, R19.1, R20.1, R25.1, R26.1, R27.1, R28.1
MISO: CON1.1, IC1.16
MOSI: CON1.4, IC1.15
unnamed: C9.1, IC1.8, U3.2
unnamed: C10.1, IC1.7, U3.1
unnamed: C13.1, IC1.20
unnamed: CON1.5, IC1.29, R67.2
unnamed: D1.2, F2.1, R1.2
unnamed: D2.2, F3.1, R2.2
unnamed: D3.2, F4.1, R3.2
unnamed: D4.2, F5.1, R4.2
unnamed: D5.2, F9.1, R9.2
unnamed: D6.2, F10.1, R10.2
unnamed: D7.2, F11.1, R11.2
unnamed: D8.2, F12.1, R12.2
unnamed: D9.2, F17.1, R17.2
unnamed: D10.2, F18.1, R18.2
unnamed: D11.2, F19.1, R19.2
unnamed: D12.2, F20.1, R20.2
unnamed: D13.2, F25.1, R25.2
unnamed: D14.2, F26.1, R26.2
unnamed: D15.2, F27.1, R27.2
unnamed: D16.2, F28.1, R28.2
unnamed: IC1.27, R69.1
unnamed: IC1.28, R68.1
unnamed: IC1.30, P2.1
unnamed: JP1.2, R66.2, R69.2
unnamed: JP2.2, R65.2, R68.2
S1: C1.1, F1.1, F2.3, R5.2, U1.1
S2: C2.1, F3.3, F6.1, R6.2, U1.2
S3: C3.1, F4.3, F7.1, R7.2, U1.4
S4: C4.1, F5.3, F8.1, R8.2, U1.5
S5: C5.1, F9.3, F13.1, R13.2, U1.12
S6: C6.1, F10.3, F14.1, R14.2, U1.13
S7: C7.1, F11.3, F15.1, R15.2, U1.14
S8: C8.1, F12.3, F16.1, R16.2, U1.15
S9: C14.1, F17.3, F21.1, R21.2, U2.1
S10: C15.1, F18.3, F22.1, R22.2, U2.2
S11: C16.1, F19.3, F23.1, R23.2, U2.4
S12: C17.1, F20.3, F24.1, R24.2, U2.5
S13: C18.1, F25.3, F29.1, R29.2, U2.12
S14: C19.1, F26.3, F30.1, R30.2, U2.13
S15: C20.1, F27.3, F31.1, R31.2, U2.14
S16: C21.1, F28.3, F32.1, R32.2, U2.15
SCK: CON1.3, IC1.17
SCL: D40.2, D41.1, JP1.3, JP2.1, P1.3
SDA: D42.2, D43.1, JP1.1, JP2.3, P1.1
SS: IC1.31, P2.2
VCC: C11.1, C12.1, C13.2, C22.1, C23.1, CON1.2, D34.1, D40.1, D42.1, IC1.4, IC1.6, IC1.18, R5.1, R6.1, R7.1, R8.1, R13.1, R14.1, R15.1, R16.1, R21.1, R22.1, R23.1, R24.1, R29.1, R30.1, R31.1, R32.1, R65.1, R66.1, R67.1, U1.16, U2.16
