teeheee/usring/(commit log)

2017-03-12 platine in fertigung
    [Kopie von usring.kicad_pcb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]
2018-03-07 cleanup and doku
    [Kopie von usring.kicad_pcb, bom.ods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]
2018-11-23 fixed buffer overflow issue
    [sensor.c]
2018-11-23 better calibration
2018-12-21 added stencil
    [stencil.scad, stencil.stl, usring_infrared-B.Paste.dxf, usring_infrared-Edge.Cuts.dxf, usring_infrared-F.Paste.dxf, usring_noInfrared-B.Paste.dxf, usring_noInfrared-F.Paste.dxf]
2018-12-21 new features (filter, single threshold)
